sparkfun/Logomatic-V2/Hardware/Logomatic.brd

## EAGLE design Hardware/Logomatic.brd (2016-01-06)

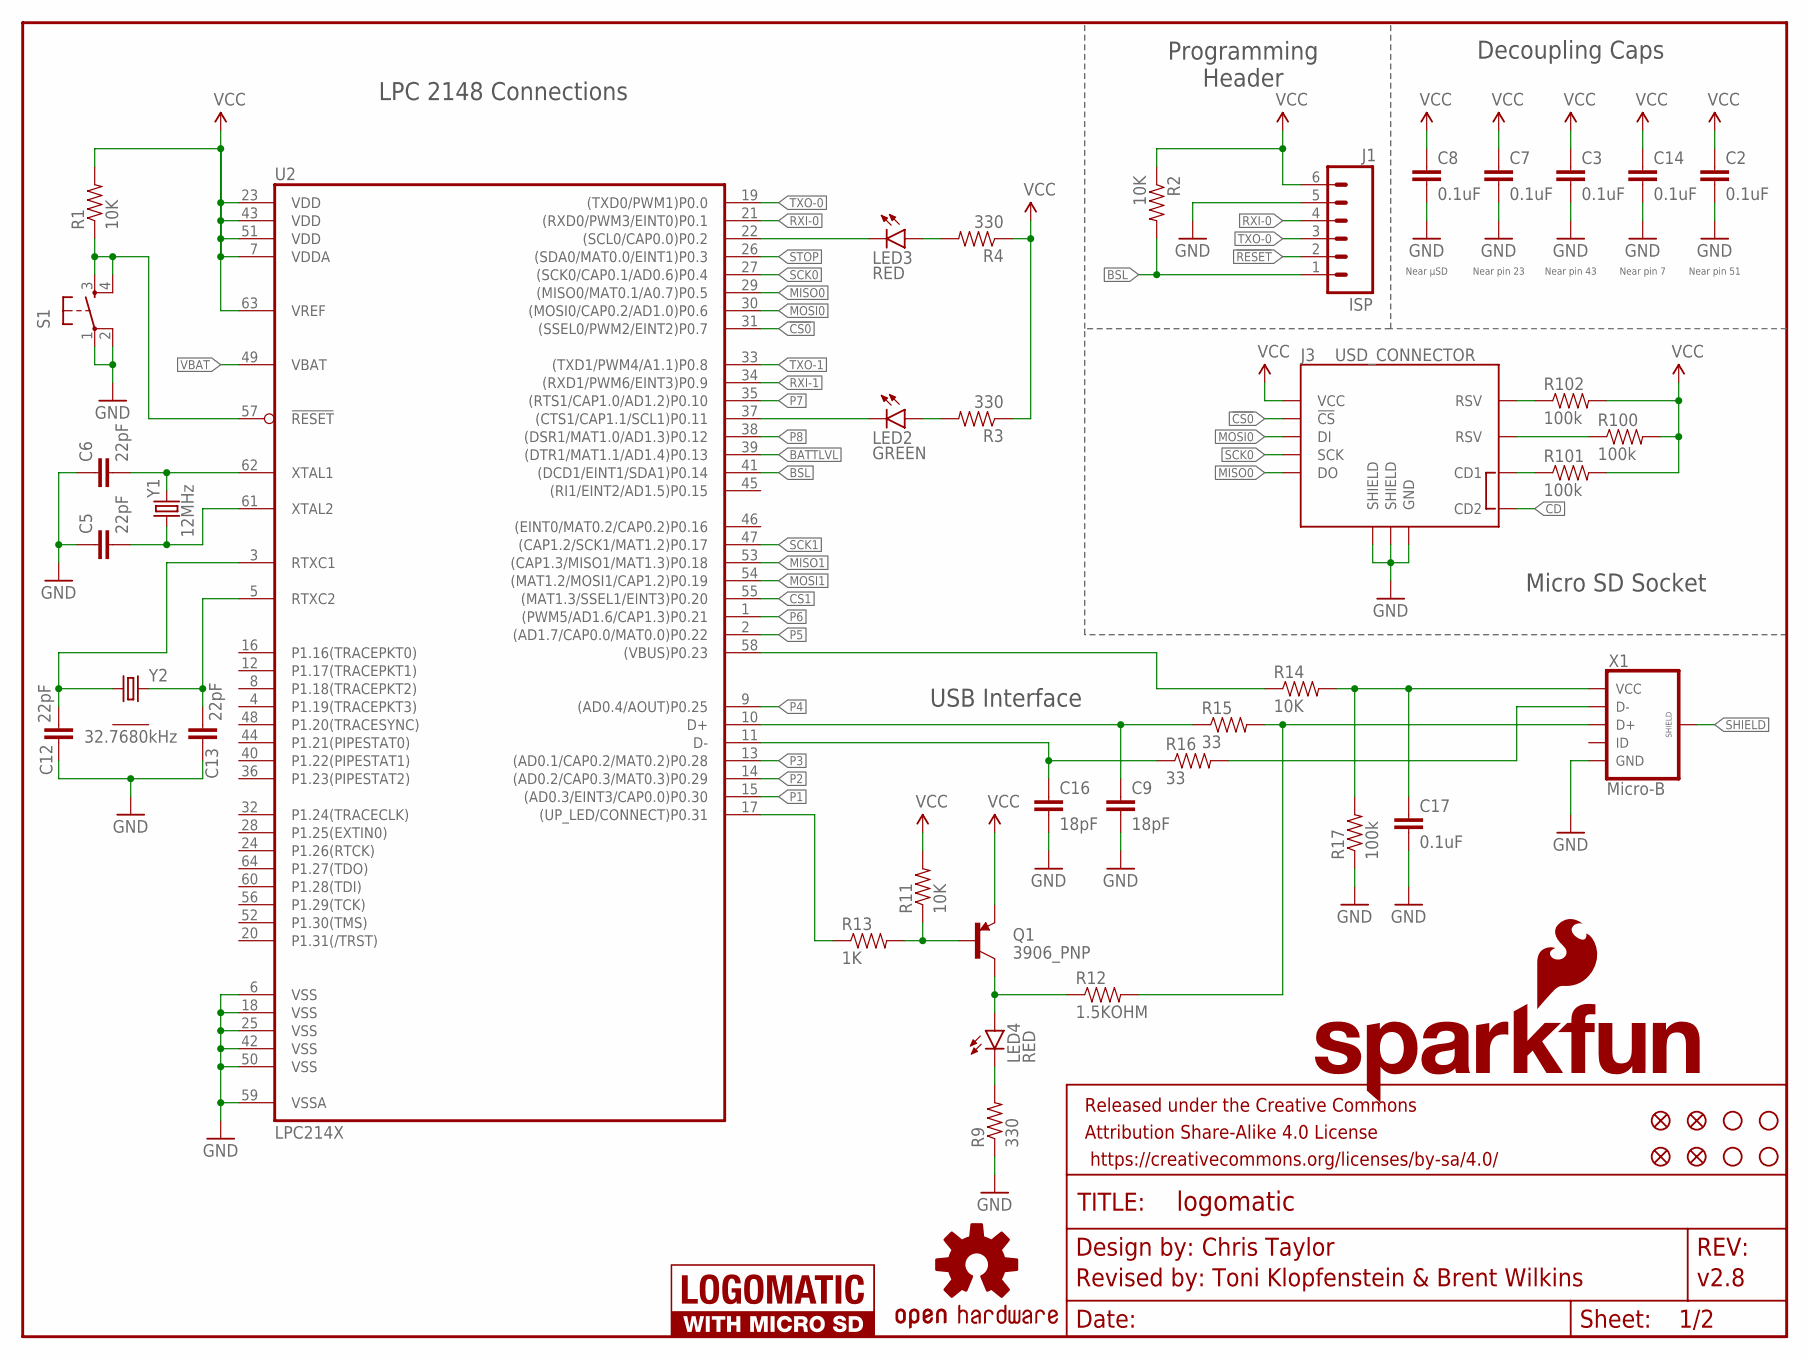
[picture p1: schematic Logomatic.sch, sheet 1]

Parts:
C2, C3, C7, C8, C14, C17: 0.1uF; 0603-CAP
C5, C6, C12, C13: 22pF; 0603-CAP
C9, C16: 18pF; 0603-CAP
FD1, FD2, FD100, FD101: FIDUCIAL1X2; FIDUCIAL-1X2
FRAME1: FRAME-LETTER; CREATIVE_COMMONS
H1, H2, H3, H4: STAND-OFF
J1: ISP; 1X06
J3: USD_CONNECTOR; MICRO-SD-SOCKET-PP
LED2: GREEN; LED-0603
LED3, LED4: RED; LED-0603
LOGO1: SFE_LOGO_NAME.1_INCH; SFE_LOGO_NAME_.1
LOGO2: SFE_LOGO_FLAME.1_INCH; SFE_LOGO_FLAME_.1
LOGO100: OSHW-LOGOL; OSHW-LOGO-L
LOGO101: LOGOMATIC_LOGO
Q1: 3906_PNP; SOT23-3
R1, R2, R11, R14: 10K; 0603-RES
R3, R4, R9: 330; 0603-RES
R12: 1.5KOHM; 0603
R13: 1K; 0603-RES
R15, R16: 33; 0603-RES
R17, R100, R101, R102: 100k; 0603-RES
S1: RESET; TACTILE-SWITCH-SMD
U2: LPC214X; LQFP-10X10-64
X1: Micro-B; USB-B-MICRO-SMD_V03
Y1: 12MHz; CRYSTAL-SMD-5X3
Y2: 32.7680kHz; 4-SOJ_5.5MM

Connections:
!CS0: J3.CS (!CS), U2.31 ((SSEL0/PWM2/EINT2)P0.7)
!RESET: J1.2, R1.1, S1.3, S1.4, U2.57 (!RESET)
BATTLVL: U2.39 ((DTR1/MAT1.1/AD1.4)P0.13); also elsewhere on the board
BSL: J1.1, R2.2, U2.41 ((DCD1/EINT1/SDA1)P0.14)
CD: J3.CD2
CS1: U2.55 ((MAT1.3/SSEL1/EINT3)P0.20); also elsewhere on the board
GND: C2.2, C3.2, C5.1, C6.1, C7.2, C8.2, C9.2, C12.1, C13.1, C14.2, C16.2, C17.2, J1.5, J3.GND, J3.GND1 (SHIELD), J3.GND3 (SHIELD), R9.1, R17.1, S1.1, S1.2, U2.6 (VSS), U2.18 (VSS), U2.25 (VSS), U2.42 (VSS), U2.50 (VSS), U2.59 (VSSA), X1.GND; also elsewhere on the board
MISO0: J3.DO, U2.29 ((MISO0/MAT0.1/A0.7)P0.5)
MISO1: U2.53 ((CAP1.3/MISO1/MAT1.3)P0.18); also elsewhere on the board
MOSI0: J3.DI, U2.30 ((MOSI0/CAP0.2/AD1.0)P0.6)
MOSI1: U2.54 ((MAT1.2/MOSI1/CAP1.2)P0.19); also elsewhere on the board
unnamed: J3.CD1, R101.1
unnamed: J3.RSV1 (RSV), R102.1
unnamed: LED3.A, R4.2
unnamed: J3.RSV2 (RSV), R100.1
unnamed: Q1.1 (B), R11.1, R13.2
unnamed: LED2.A, R3.2
unnamed: LED4.C, R9.2
P1: U2.15 ((AD0.3/EINT3/CAP0.0)P0.30); also elsewhere on the board
P2: U2.14 ((AD0.2/CAP0.3/MAT0.3)P0.29); also elsewhere on the board
P3: U2.13 ((AD0.1/CAP0.2/MAT0.2)P0.28); also elsewhere on the board
P4: U2.9 ((AD0.4/AOUT)P0.25); also elsewhere on the board
P5: U2.2 ((AD1.7/CAP0.0/MAT0.0)P0.22); also elsewhere on the board
P6: U2.1 ((PWM5/AD1.6/CAP1.3)P0.21); also elsewhere on the board
P7: U2.35 ((RTS1/CAP1.0/AD1.2)P0.10); also elsewhere on the board
P8: U2.38 ((DSR1/MAT1.0/AD1.3)P0.12); also elsewhere on the board
P-D+: C9.1, R15.1, U2.10 (D+)
P-D-: C16.1, R16.1, U2.11 (D-)
RTXC1: C12.2, U2.3 (RTXC1), Y2.1
RTXC2: C13.2, U2.5 (RTXC2), Y2.4
RXI-0: J1.4, U2.21 ((RXD0/PWM3/EINT0)P0.1)
RXI-1: U2.34 ((RXD1/PWM6/EINT3)P0.9); also elsewhere on the board
SCK0: J3.SCLK (SCK), U2.27 ((SCK0/CAP0.1/AD0.6)P0.4)
SCK1: U2.47 ((CAP1.2/SCK1/MAT1.2)P0.17); also elsewhere on the board
SHIELD: X1.SHIELD1 (SHIELD), X1.SHIELD2 (SHIELD), X1.SHIELD3 (SHIELD)
STAT: LED4.A, Q1.3 (C), R12.1
STAT0: LED3.C, U2.22 ((SCL0/CAP0.0)P0.2)
STAT1: LED2.C, U2.37 ((CTS1/CAP1.1/SCL1)P0.11)
STOP: U2.26 ((SDA0/MAT0.0/EINT1)P0.3); also elsewhere on the board
TXO-0: J1.3, U2.19 ((TXD0/PWM1)P0.0)
TXO-1: U2.33 ((TXD1/PWM4/A1.1)P0.8); also elsewhere on the board
UP_LED: R13.1, U2.17 ((UP_LED/CONNECT)P0.31)
USB_D+: R12.2, R15.2, X1.D+
USB_D-: R16.2, X1.D-
USB_VIN: C17.1, R14.2, R17.2, X1.VBUS (VCC); also elsewhere on the board
VBAT: U2.49 (VBAT); also elsewhere on the board
VBUS: R14.1, U2.58 ((VBUS)P0.23)
VCC: C2.1, C3.1, C7.1, C8.1, C14.1, J1.6, J3.VCC, Q1.2 (E), R1.2, R2.1, R3.1, R4.1, R11.2, R100.2, R101.2, R102.2, U2.7 (VDDA), U2.23 (VDD), U2.43 (VDD), U2.51 (VDD), U2.63 (VREF); also elsewhere on the board
XTAL1: C6.2, U2.62 (XTAL1), Y1.3 (2)
XTAL2: C5.2, U2.61 (XTAL2), Y1.1

Notes on the sheet:
Near pin 23
Near pin 43
Near pin 51
Decoupling Caps
Programming Header
USB Interface
Micro SD Socket
Near pin 7
LPC 2148 Connections
Near µSD

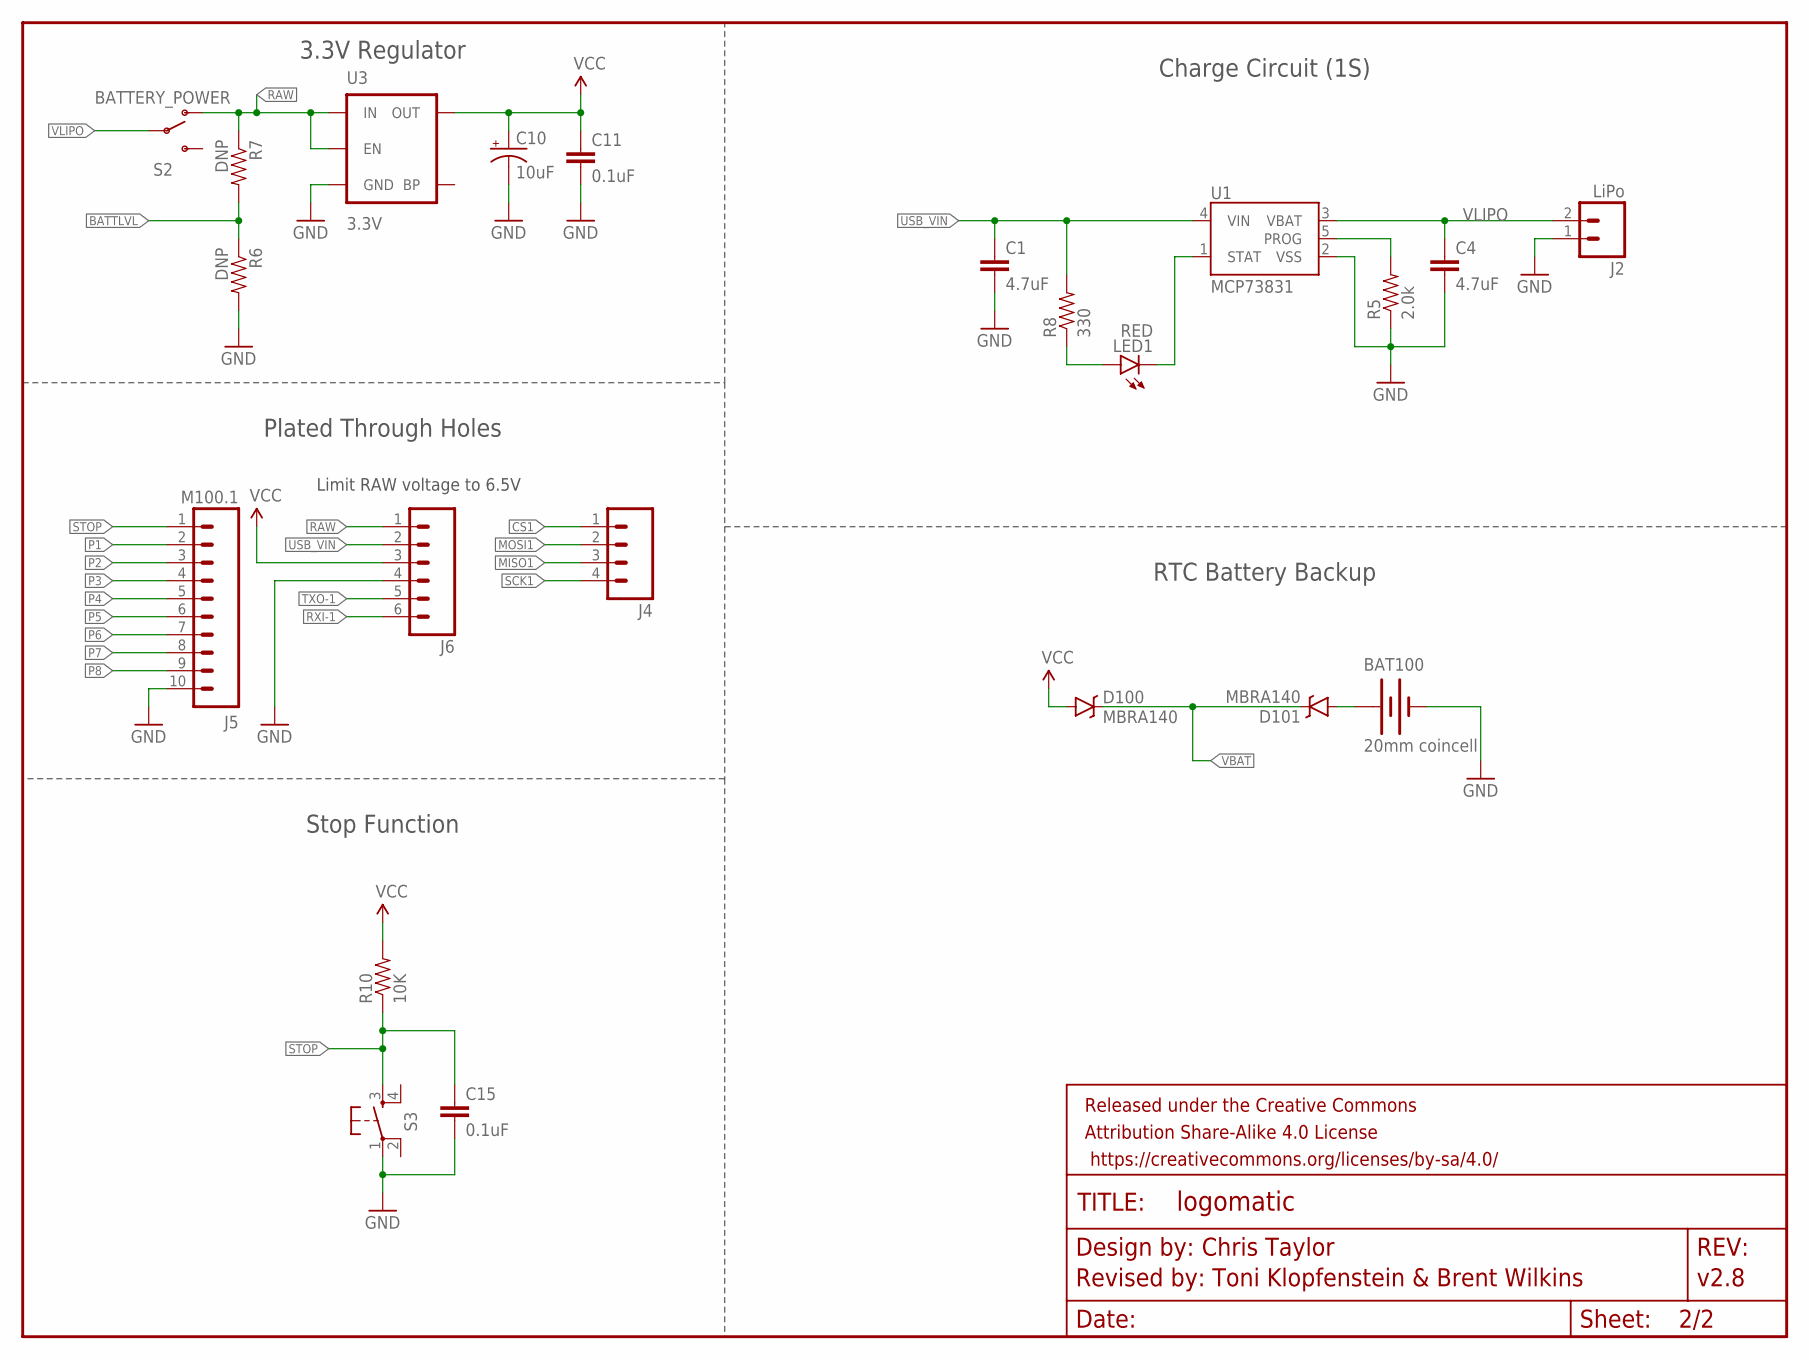
[picture p2: schematic Logomatic.sch, sheet 2]

Parts:
BAT100: 20mm coincell; BATTCON_20MM_4LEGS
C1, C4: 4.7uF; 0603-CAP
C10: 10uF; EIA3216
C11, C15: 0.1uF; 0603-CAP
D100, D101: MBRA140; SMA-DIODE
FRAME2: FRAME-LETTERNO_PACKAGE; DUMMY
J2: LiPo; JST-2-SMD
J4: M04PTH; 1X04
J5: M100.1; 1X10
J6: M06SILK_FEMALE_PTH; 1X06
LED1: RED; LED-0603
R5: 2.0k; 0603-RES
R6, R7: DNP; 0603-RES
R8: 330; 0603-RES
R10: 10K; 0603-RES
S2: BATTERY_POWER; AYZ0202
S3: TAC_SWITCHSMD; TACTILE-SWITCH-SMD
U1: MCP73831; SOT23-5
U3: 3.3V; SOT23-5

Connections:
BATTLVL: R6.1, R7.2; also elsewhere on the board
CS1: J4.1; also elsewhere on the board
GND: BAT100.NEGATIVE (-), C1.2, C4.2, C10.C (-), C11.2, C15.2, J2.1 (2), J5.10, J6.4, R5.1, R6.2, S3.1, U1.2 (VSS), U3.2 (GND); also elsewhere on the board
MISO1: J4.3; also elsewhere on the board
MOSI1: J4.2; also elsewhere on the board
unnamed: R5.2, U1.5 (PROG)
unnamed: BAT100.POSITIVE@1 (+), BAT100.POSITIVE@2 (+), BAT100.POSITIVE@3 (+), BAT100.POSITIVE@4 (+), D101.A
unnamed: LED1.C, U1.1 (STAT)
unnamed: LED1.A, R8.1
P1: J5.2; also elsewhere on the board
P2: J5.3; also elsewhere on the board
P3: J5.4; also elsewhere on the board
P4: J5.5; also elsewhere on the board
P5: J5.6; also elsewhere on the board
P6: J5.7; also elsewhere on the board
P7: J5.8; also elsewhere on the board
P8: J5.9; also elsewhere on the board
RAW: J6.1, R7.1, S2.1 (O), U3.1 (IN), U3.3 (EN)
RXI-1: J6.6; also elsewhere on the board
SCK1: J4.4; also elsewhere on the board
STOP: C15.1, J5.1, R10.1, S3.3; also elsewhere on the board
TXO-1: J6.5; also elsewhere on the board
USB_VIN: C1.1, J6.2, R8.2, U1.4 (VIN); also elsewhere on the board
VBAT: D100.C, D101.C; also elsewhere on the board
VCC: C10.A (+), C11.1, D100.A, J6.3, R10.2, U3.5 (OUT); also elsewhere on the board
VLIPO: C4.1, J2.2 (1), S2.2, U1.3 (VBAT)

Notes on the sheet:
3.3V Regulator
Charge Circuit (1S)
Plated Through Holes
Stop Function
RTC Battery Backup
Limit RAW voltage to 6.5V

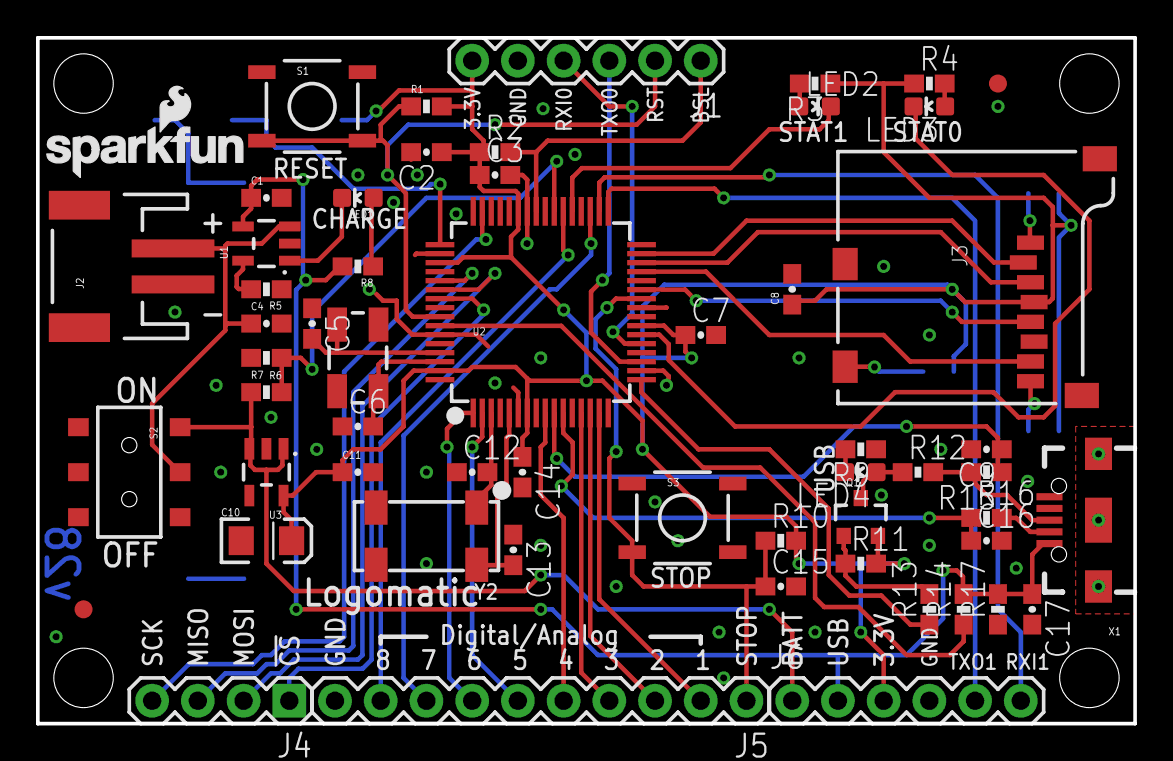
[picture p3: board Logomatic.brd from above]

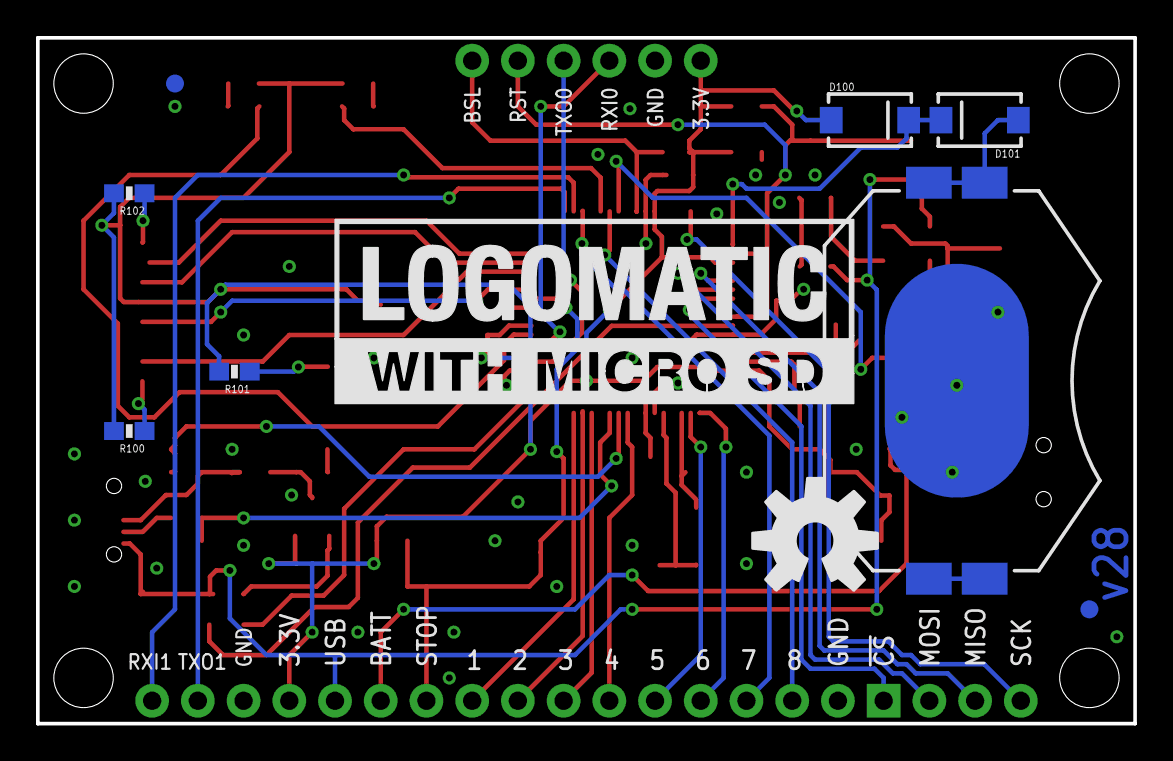
[picture p4: board Logomatic.brd from below]

Board: 2 copper layers, 61.0 x 38.1 mm, 74 parts (10 on the bottom side), 55 nets.
