sparkfun/Logomatic-V2/(commit log)

2015-12-31 Added coin cell holder
    [Logomatic.brd, Logomatic.sch]
2016-01-06 Fixed issue #9 on GitHub
    [Logomatic.brd, Logomatic.sch]
